dxqcod/lora-dx/hardware/schematics/text-scheme-controller.md

```
Текстовая схема подключения блока управления:
________________________________________
1. ESP8266 (Wemos D1 Mini):
•	D5 (LORA_RX): Подключён к TX модуля LoRa.
•	D6 (LORA_TX): Подключён к RX модуля LoRa.
•	D1 (RELAY_PIN): Подключён к IN1 первого реле (ретранслятор).
•	D3 (SERVO_PIN): Подключён к сигнальному проводу сервопривода.
•	D2 (D2_PIN): Подключён для считывания состояния.
•	D0 (D0_PIN): Подключён к IN2 второго реле (вентилятор).
•	D4 (D4_PIN): Подключён к IN3 третьего реле (камера).
•	D7 (ONE_WIRE_BUS): Подключён к DQ датчика температуры DS18B20.
•	3.3V: Подключён к VCC модуля LoRa и VCC датчика температуры.
•	GND: Подключён к GND модуля LoRa, GND реле, GND сервопривода и GND датчика температуры.
________________________________________
2. Модуль LoRa Ebyte E220:
•	TX: Подключён к D5 (LORA_RX) на ESP8266.
•	RX: Подключён к D6 (LORA_TX) на ESP8266.
•	VCC: Подключён к 3.3V на ESP8266.
•	GND: Подключён к GND на ESP8266.
________________________________________
3. Реле:
•	Реле 1 (ретранслятор):
	IN1: Подключён к D1 (RELAY_PIN) на ESP8266.
	VCC: Подключён к 5V (внешний источник питания).
	GND: Подключён к GND на ESP8266.
•	Реле 2 (вентилятор):
	IN2: Подключён к D0 (D0_PIN) на ESP8266.
	VCC: Подключён к 5V (внешний источник питания).
	GND: Подключён к GND на ESP8266.
•	Реле 3 (камера):
	IN3: Подключён к D4 (D4_PIN) на ESP8266.
	VCC: Подключён к 5V (внешний источник питания).
	GND: Подключён к GND на ESP8266.
________________________________________
4. Сервопривод:
•	Сигнальный провод: Подключён к D3 (SERVO_PIN) на ESP8266.
•	VCC: Подключён к 5V (внешний источник питания).
•	GND: Подключён к GND на ESP8266.
________________________________________
5. Датчик температуры DS18B20:
•	DQ: Подключён к D7 (ONE_WIRE_BUS) на ESP8266.
•	VCC: Подключён к 3.3V на ESP8266.
•	GND: Подключён к GND на ESP8266.
________________________________________
Краткое описание подключений:
•	LoRa модуль: TX → D5, RX → D6, VCC → 3.3V, GND → GND.
•	Реле 1 (ретранслятор): IN1 → D1, VCC → 5V, GND → GND.
•	Реле 2 (вентилятор): IN2 → D0, VCC → 5V, GND → GND.
•	Реле 3 (камера): IN3 → D4, VCC → 5V, GND → GND.
•	Сервопривод: Сигнальный провод → D3, VCC → 5V, GND → GND.
•	Датчик температуры DS18B20: DQ → D7, VCC → 3.3V, GND → GND.
•	Кнопка: Один контакт → D2, другой → GND.
```

<p align="center">
  <a href="/docs/photos/wemos.jpg">
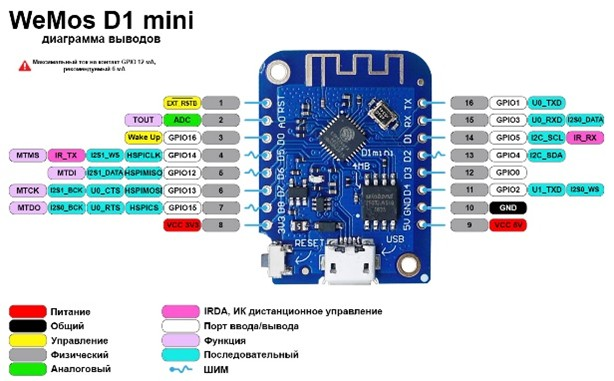
[picture p12: docs/photos/wemos.jpg]
    
  </a>
</p>
