dxqcod/lora-dx/hardware/schematics/text-scheme-remote.md

```
Текстовая схема подключения пульта управления:

1. ESP8266 (Wemos D1 Mini):
•	D5 (LORA_RX): Подключён к TX модуля LoRa.
•	D6 (LORA_TX): Подключён к RX модуля LoRa.
•	D7 (BUTTON_PIN): Подключён к кнопке (другой конец кнопки подключён к GND).
•	D3 (BUTTON_CAM_PIN): Подключён к кнопке камеры (другой конец кнопки подключён к GND).
•	LED_BUILTIN (встроенный светодиод): Подключён к GND через резистор (если требуется).
•	A0 (POTENTIOMETER_PIN): Подключён к среднему выводу потенциометра.
	Один крайний вывод потенциометра подключён к 3.3V.
	Другой крайний вывод подключён к GND.
•	SDA (I2C): Подключён к SDA дисплея SSD1306.
•	SCL (I2C): Подключён к SCL дисплея SSD1306.
•	3.3V: Подключён к VCC модуля LoRa и дисплея SSD1306.
•	GND: Подключён к GND модуля LoRa, дисплея SSD1306, кнопок, потенциометра и светодиода.
________________________________________
2. Модуль LoRa Ebyte E220:
•	TX: Подключён к D5 (LORA_RX) на ESP8266.
•	RX: Подключён к D6 (LORA_TX) на ESP8266.
•	VCC: Подключён к 3.3V на ESP8266.
•	GND: Подключён к GND на ESP8266.
________________________________________
3. Дисплей SSD1306 (I2C):
•	VCC: Подключён к 3.3V на ESP8266.
•	GND: Подключён к GND на ESP8266.
•	SDA: Подключён к SDA на ESP8266.
•	SCL: Подключён к SCL на ESP8266.
________________________________________
4. Кнопка (BUTTON_PIN):
•	Один контакт подключён к D7 на ESP8266.
•	Другой контакт подключён к GND.
________________________________________
5. Кнопка камеры (BUTTON_CAM_PIN):
•	Один контакт подключён к D3 на ESP8266.
•	Другой контакт подключён к GND.
________________________________________
6. Потенциометр:
•	Средний вывод: Подключён к A0 на ESP8266.
•	Один крайний вывод: Подключён к 3.3V.
•	Другой крайний вывод: Подключён к GND.
________________________________________
7. Встроенный светодиод (LED_BUILTIN):
•	Подключён к GND через резистор (если требуется).
________________________________________
Краткое описание подключений:
•	LoRa модуль: TX → D5, RX → D6, VCC → 3.3V, GND → GND.
•	Дисплей SSD1306: VCC → 3.3V, GND → GND, SDA → SDA, SCL → SCL.
•	Кнопка: Один контакт → D7, другой → GND.
•	Кнопка камеры: Один контакт → D3, другой → GND.
•	Потенциометр: Средний вывод → A0, крайние выводы → 3.3V и GND.
•	Светодиод: Подключён к LED_BUILTIN и GND.
```

<p align="center">
  <a href="/hardware/wiring-diagrams.png">
    
  </a>
</p>

hardware/wiring-diagrams.png
