dxqcod/lora-dx/(commit log)

2025-09-14 Rename картинка.jpg to фронт с пояснениями.jpg
2025-09-14 Rename фронт с пояснениями.jpg to fronr_view_comments.jpg
